dfreitas-git/CurveTracer/BOM_Curve-Tracer-V3.csv

ID | Name | Designator | Footprint | Quantity | Manufacturer Part | Manufacturer | Supplier | Supplier Part | Price
1 | 0.1u | C1,C2,C4,C8,C9,C10,C11 | RAD-0.3 | 7
2 | 0.22u | C3,C14 | RAD-0.3 | 2
3 | 100u | C5,C6,C7,C15 | CAP-D6.3-F2.5 | 4
4 | IL9341 TFT Header | H3 | CONN-ILI9341_DLF | 1 |  | Ckmtw(灿科盟) | LCSC | C168990 | 0.056
5 | 33k | R1,R3,R4,R26,R28,R30,R32,R36,R37,R38 | R_AXIAL-0.4 | 10
6 | 68k | R2,R5,R6 | R_AXIAL-0.4 | 3
7 | 100k | R7 | R_AXIAL-0.4 | 1
8 | 20k | R8,R40,R43 | R_AXIAL-0.4 | 3
9 | 27k | R9 | R_AXIAL-0.4 | 1
10 | 100/.5w | R10,R34 | R_AXIAL-0.6 | 2
11 | 10k | R11,R12,R23,R24,R39,R44 | R_AXIAL-0.4 | 6
12 | 2.2k | R13,R15,R17,R19,R21,R46 | R_AXIAL-0.4 | 6
13 | 3.3k | R14,R16,R18,R20,R22 | R_AXIAL-0.4 | 5
14 | 47k | R25,R27,R29,R31,R35 | R_AXIAL-0.4 | 5
15 | 470/1w | R33 | R_AXIAL-0.8 | 1
16 | 120k | R41,R42 | R_AXIAL-0.4 | 2
17 | 270 | R45 | R_AXIAL-0.4 | 1
18 | 150 | R47 | R_AXIAL-0.4 | 1
29 | ARDUINO_NANO | U1 | COMM-TH_ARDUINO_NANO | 1 |  | null | LCSC | C9900017879
20 | TCA0372DWG_C150939 | U2,U6 | SOIC-16_L10.3-W7.5-P1.27-LS10.3-BL | 2 | TCA0372DWG | onsemi(安森美) | LCSC | C150939 | 1.131
21 | MCP4802-E/P | U3 | PDIP-8_L9.3-W6.4-P2.54-LS7.6-BL | 1 |  | MICROCHIP(美国微芯) | LCSC | C640386 | 3.384
22 | ZIF16 | U4 | SH_ZIF16 | 1 | ZIF16
23 | 3.3v | U5 | 3.3V BUCK - DLF | 1 |  | TI(德州仪器) | LCSC | C18910 | 1.953
24 | LM7805 | U7 | TO-220-3_L10.0-W4.5-P2.54-L | 1 | LM7805CT | onsemi(安森美) | LCSC | C22146
25 | Daughter Connect | U8,U9 | HDR-TH_6P-P2.50-V-F-2 | 2 | 2.54-6P ZZDK | SHOU HAN(首韩) | LCSC | C18185653 | 0.032
26 | Power Connector | U11 | HDR-TH_6P-P2.50-V-F-2 | 1 | 2.54-6P ZZDK | SHOU HAN(首韩) | LCSC | C18185653 | 0.032
27 | LM338T | U12 | TO-220-3_L10.2-W4.5-P2.54-L-1 | 1 | LM338T | HGSEMI(华冠) | LCSC | C512788 | 0.661
