dfreitas-git/CurveTracer/(commit log)

2024-02-07 Added grid setup menu. Added separate inc/dec buttons in setup menus. Added increment field to be able to change the increment value
2024-02-08 Zener diode test/return buttons working. Added zener diode symbol bitmaps
2024-02-08 Print Vz or Vt for diodes after scanning
2024-02-10 Reset the Vz/Vt value after returning from the scan screen
    [main.cpp]
2024-02-10 added debug printing of VccDac and Vcc-OpAmp output
2024-02-10 Fixed bug where previous diode threshold voltage was still being displayed after returning from test
    [main.cpp]
2024-02-10 Added S/s commands to sweep the Dacs (with and without printing to the serial monitor). Suppress printing when wanting a faster ramp to view on a scope.
2024-02-11 Some Zeners will start testing automatically if the zener current is enough to trigger the test. Needed to flag the case where the manual button was used so we would draw the return button to get bac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
2024-02-11 Updated README.md with schematics, pcb and Gerber links
2024-03-01 Updated to Rev3 schematics/gerbers
2024-03-03 Added the new zener diode test code
2024-03-03 Added Rev3.0 DAC vs OpAmp output chart. Updated README.md to include rev3.0 note. Updated main.cpp to include separate Zener Diode test
2024-05-23 Added BOM
    [BOM_Curve-Tracer-V3.csv]
2025-04-22 Fixed zener diode display scaling when changing the x-axis limits
    [main.cpp]
2025-04-22 add power shutoff for zener diode
